christine222/TeamToast/ToastSchematic.brd

## EAGLE design ToastSchematic.brd (2017-12-01)

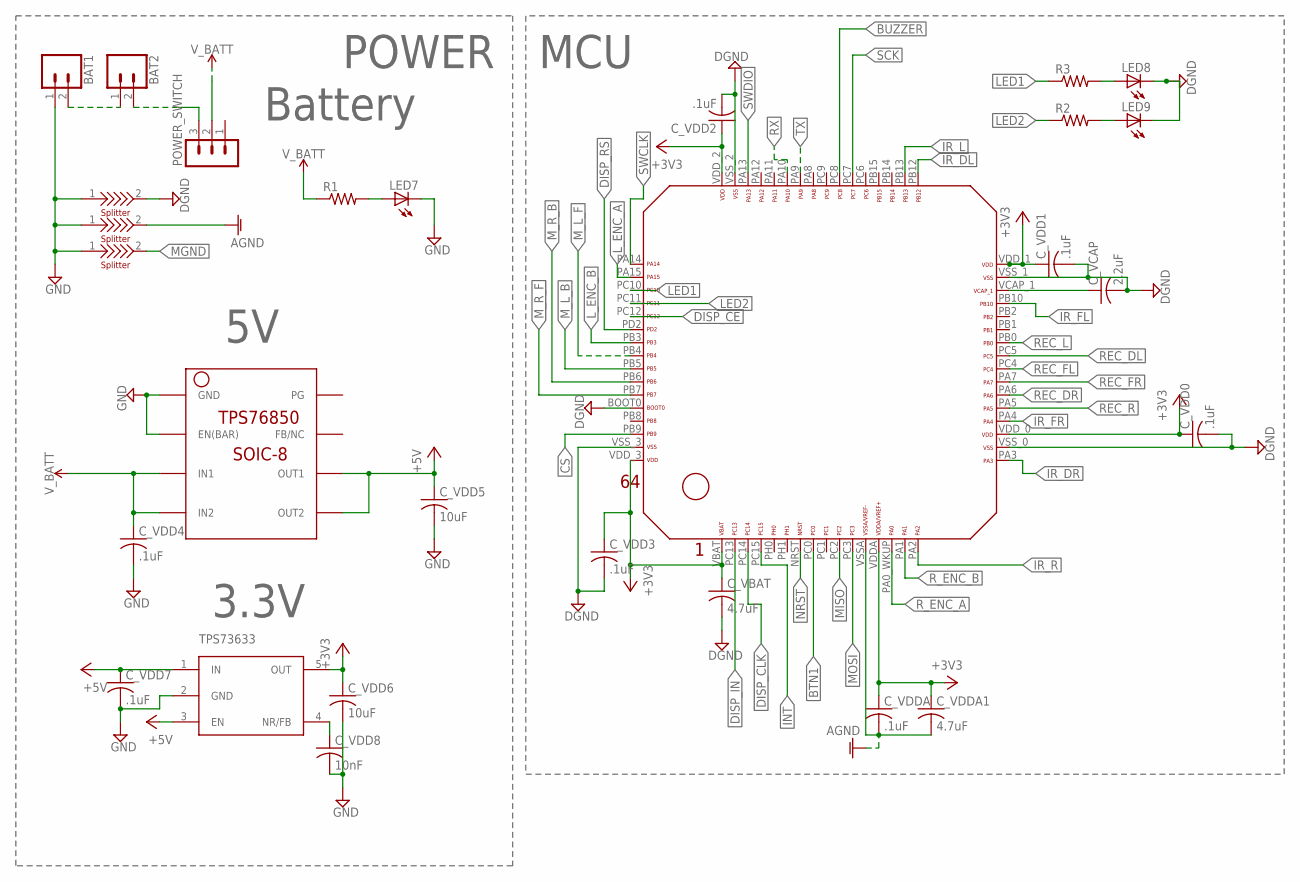
[picture p1: schematic ToastSchematic.sch, sheet 1]

Parts:
BAT1, BAT2: CONN_02JST-PTH-2; JST-2-PTH
C_VBAT: 4.7uF; C0603
C_VCAP: 2.2uF; C0603
C_VDD0, C_VDD1, C_VDD2, C_VDD3, C_VDD4, C_VDD7: .1uF; C0603
C_VDD5, C_VDD6: 10uF; C0603
C_VDD8: 10nF; C0603
C_VDDA: .1uF; C0603
C_VDDA1: 4.7uF; C0603
LED7: LED5MM
LED8, LED9: LEDCHIPLED_0603; CHIPLED_0603
POWER_SWITCH: MA03-1
R1, R2, R3: R-US_R0603; R0603
U$1: STM32F411/446_LQFP64
U$2: TPS73633; SOT23-5L
U$3: TPS76850(SOIC-8)
U$5, U$8, U$9: SPLITTER

Connections:
+3V3: C_VBAT.1, C_VDD0.1, C_VDD1.1, C_VDD2.1, C_VDD3.1, C_VDD6.1, C_VDDA.1, C_VDDA1.1, U$1.VBAT, U$1.VDDA, U$1.VDD_0, U$1.VDD_1, U$1.VDD_2, U$1.VDD_3, U$2.5 (OUT); also elsewhere on the board
+5V: C_VDD5.1, C_VDD7.1, U$2.1 (IN), U$2.3 (EN), U$3.OUT1, U$3.OUT2; also elsewhere on the board
AGND: C_VDDA.2, C_VDDA1.2, U$1.VSSA, U$8.2; also elsewhere on the board
BTN1: U$1.PC0; also elsewhere on the board
BUZZER: U$1.PC8; also elsewhere on the board
CS: U$1.PB9; also elsewhere on the board
DGND: C_VBAT.2, C_VCAP.2, C_VDD0.2, C_VDD1.2, C_VDD2.2, C_VDD3.2, LED8.C, LED9.C, U$1.BOOT0, U$1.VSS_0, U$1.VSS_1, U$1.VSS_2, U$1.VSS_3, U$5.2; also elsewhere on the board
DISP_CE: U$1.PC12; also elsewhere on the board
DISP_CLK: U$1.PC14; also elsewhere on the board
DISP_IN: U$1.PC13; also elsewhere on the board
DISP_RS: U$1.PD2; also elsewhere on the board
GND: BAT1.1, C_VDD4.2, C_VDD5.2, C_VDD6.2, C_VDD7.2, C_VDD8.2, LED7.K (C), U$2.2 (GND), U$3.EN(BAR), U$3.GND, U$5.1, U$8.1, U$9.1
INT: U$1.PC15; also elsewhere on the board
IR_DL: U$1.PB12; also elsewhere on the board
IR_DR: U$1.PA3; also elsewhere on the board
IR_FL: U$1.PB10; also elsewhere on the board
IR_FR: U$1.PA4; also elsewhere on the board
IR_L: U$1.PB13; also elsewhere on the board
IR_R: U$1.PA2; also elsewhere on the board
LED1: R3.1, U$1.PC10
LED2: R2.1, U$1.PC11
L_ENC_A: U$1.PA15; also elsewhere on the board
L_ENC_B: U$1.PB3; also elsewhere on the board
MGND: U$9.2; also elsewhere on the board
MISO: U$1.PC2; also elsewhere on the board
MOSI: U$1.PC3; also elsewhere on the board
M_L_B: U$1.PB5; also elsewhere on the board
M_L_F: U$1.PB4; also elsewhere on the board
M_R_B: U$1.PB6; also elsewhere on the board
M_R_F: U$1.PB7; also elsewhere on the board
unnamed: BAT1.2, BAT2.1
unnamed: BAT2.2, POWER_SWITCH.3
unnamed: C_VCAP.1, U$1.VCAP_1
unnamed: C_VDD8.1, U$2.4 (NR/FB)
unnamed: LED7.A, R1.2
unnamed: LED8.A, R3.2
unnamed: LED9.A, R2.2
NRST: U$1.NRST; also elsewhere on the board
REC_DL: U$1.PC5; also elsewhere on the board
REC_DR: U$1.PA6; also elsewhere on the board
REC_FL: U$1.PC4; also elsewhere on the board
REC_FR: U$1.PA7; also elsewhere on the board
REC_L: U$1.PB0; also elsewhere on the board
REC_R: U$1.PA5; also elsewhere on the board
RX: U$1.PA10; also elsewhere on the board
R_ENC_A: U$1.PA0_WKUP (PA0_AKUP); also elsewhere on the board
R_ENC_B: U$1.PA1; also elsewhere on the board
SCK: U$1.PC7; also elsewhere on the board
SWCLK: U$1.PA14; also elsewhere on the board
SWDIO: U$1.PA13; also elsewhere on the board
TX: U$1.PA9; also elsewhere on the board
V_BATT: C_VDD4.1, POWER_SWITCH.2, R1.1, U$3.IN1, U$3.IN2; also elsewhere on the board

Notes on the sheet:
MCU
POWER
3.3V
Battery

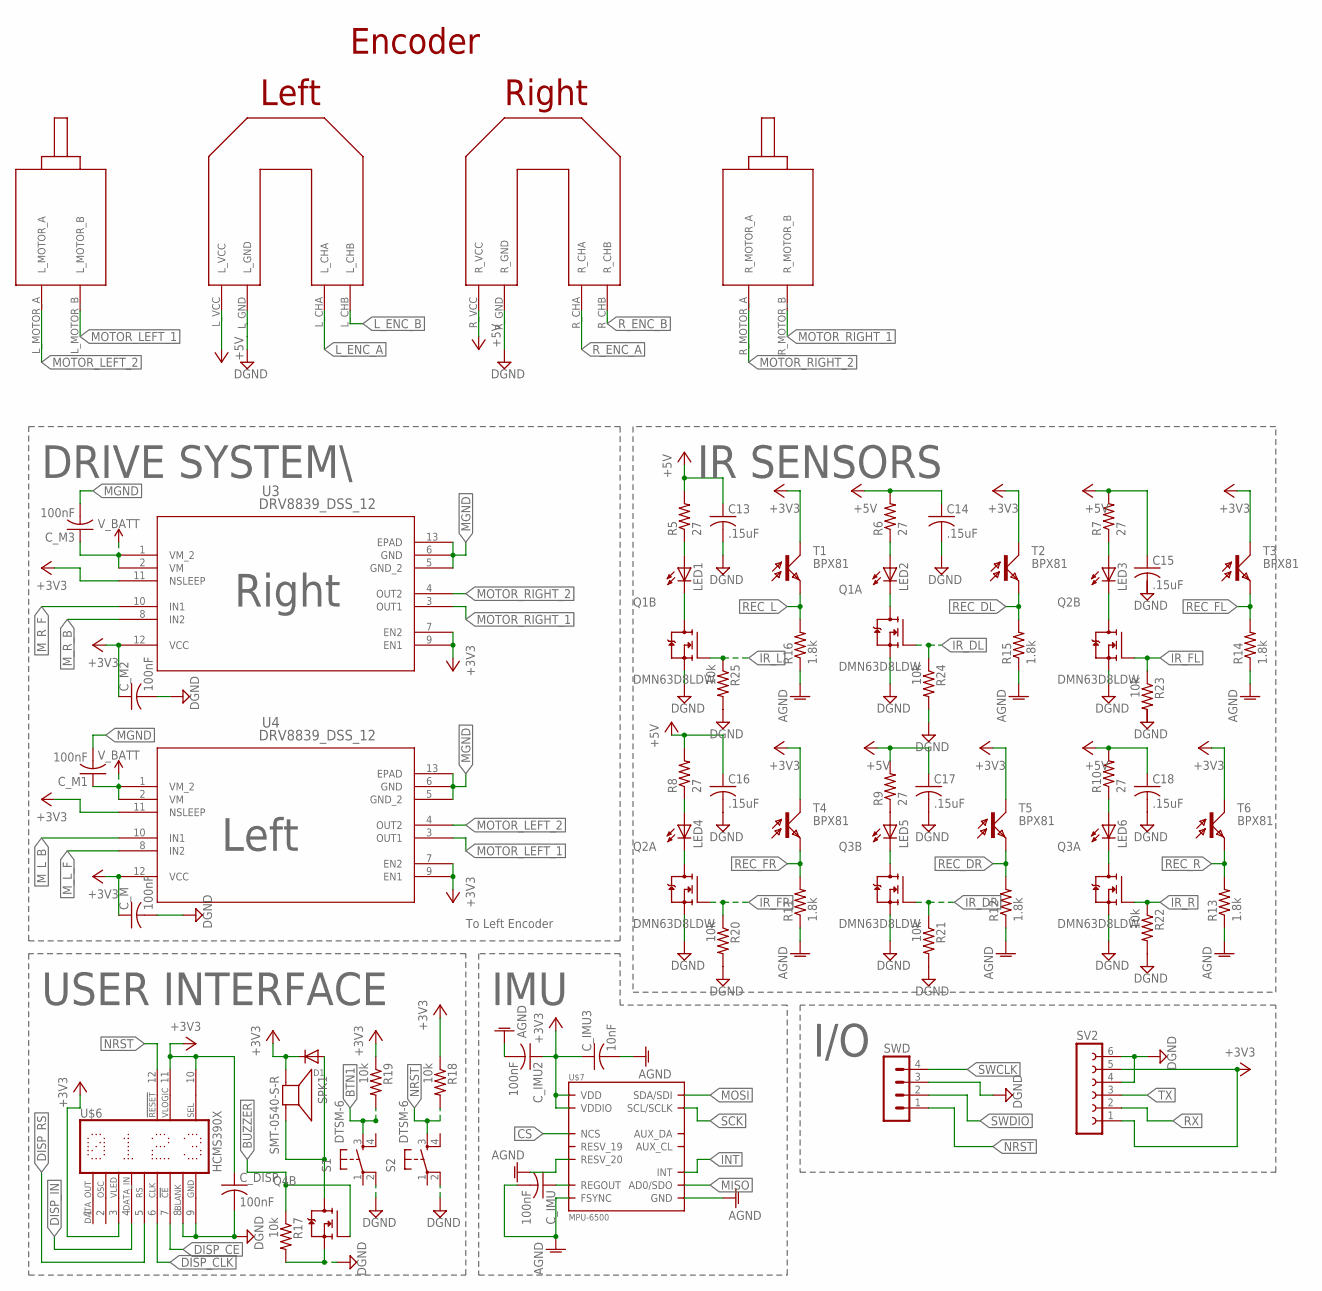
[picture p2: schematic ToastSchematic.sch, sheet 2]

Parts:
C13, C14, C15, C16, C17, C18: .15uF; C0603K
C_DISP: 100nF; C0603K
C_IMU, C_IMU2: 100nF; C0603K
C_IMU3: 10nF; C0603K
C_M, C_M1, C_M2, C_M3: 100nF; C0603K
D1: DIODESOD-323F; SOD-323F
LED1, LED2, LED3, LED4, LED5, LED6: LED5MM
Q1, Q2, Q3, Q4: DMN63D8LDW; SOT363
R5, R6, R7, R8, R9, R10: 27; R0603
R11, R12, R13, R14, R15, R16: 1.8k; R0603
R17, R18, R19, R20, R21, R22, R23, R24, R25: 10k; R0603
S1, S2: DTSM-6
SPK1: SMT-0540-S-R
SV2: FE06-1; FE06
SWD: MA04-1
T1, T2, T3, T4, T5, T6: BPX81
U3, U4: DRV8839_DSS_12; DSS12_P9X2
U$4: FUTURA_V1.0_MOTOR_MOUNT; FUTURA_V1.0_MOTOT_MOUNT
U$6: HCMS390X
U$7: MPU-6500; QFN.24.4X4

Connections:
+3V3: C_DISP.1, C_IMU2.1, C_IMU3.1, C_M.1, C_M2.1, D1.C, R18.1, R19.1, SPK1.- (+), SV2.1, SV2.5, T1.C, T2.C, T3.C, T4.C, T5.C, T6.C, U3.7 (EN2), U3.9 (EN1), U3.11 (NSLEEP), U3.12 (VCC), U4.7 (EN2), U4.9 (EN1), U4.11 (NSLEEP), U4.12 (VCC), U$6.3 (VLED), U$6.10 (SEL), U$6.11 (VLOGIC), U$7.8 (VDDIO), U$7.13 (VDD); also elsewhere on the board
+5V: C13.1, C14.1, C15.1, C16.1, C17.1, C18.1, R5.2, R6.2, R7.2, R8.2, R9.2, R10.2, U$4.L_VCC, U$4.R_VCC; also elsewhere on the board
AGND: C_IMU.2, C_IMU2.2, C_IMU3.2, R11.1, R12.1, R13.1, R14.1, R15.1, R16.1, U$7.11 (FSYNC), U$7.18 (GND), U$7.20 (RESV_20); also elsewhere on the board
BTN1: R19.2, S1.3; also elsewhere on the board
BUZZER: Q4.5 (G), R17.1; also elsewhere on the board
CS: U$7.22 (NCS); also elsewhere on the board
DGND: C13.2, C14.2, C16.2, C17.2, C18.2, C_DISP.2, C_M.2, C_M2.2, Q1.1 (S), Q1.4 (S), Q2.1 (S), Q2.4 (S), Q3.1 (S), Q3.4 (S), Q4.4 (S), R17.2, R20.2, R21.2, R22.2, R24.2, R25.2, S1.2, S2.2, SV2.4, SV2.6, SWD.3, U$4.L_GND, U$4.R_GND, U$6.8 (BLANK), U$6.9 (GND); also elsewhere on the board
DISP_CE: U$6.7 (!CE); also elsewhere on the board
DISP_CLK: U$6.6 (CLK); also elsewhere on the board
DISP_IN: U$6.4 (IN); also elsewhere on the board
DISP_RS: U$6.5 (RS); also elsewhere on the board
INT: U$7.12 (INT); also elsewhere on the board
IR_DL: Q1.2 (G), R24.1; also elsewhere on the board
IR_DR: Q3.5 (G), R21.1; also elsewhere on the board
IR_FL: Q2.5 (G), R23.1; also elsewhere on the board
IR_FR: Q2.2 (G), R20.1; also elsewhere on the board
IR_L: Q1.5 (G), R25.1; also elsewhere on the board
IR_R: Q3.2 (G), R22.1; also elsewhere on the board
L_ENC_A: U$4.L_CHA; also elsewhere on the board
L_ENC_B: U$4.L_CHB; also elsewhere on the board
MGND: C_M1.2, C_M3.2, U3.5 (GND_2), U3.6 (GND), U3.13 (EPAD), U4.5 (GND_2), U4.6 (GND), U4.13 (EPAD); also elsewhere on the board
MISO: U$7.9 (AD0/SDO); also elsewhere on the board
MOSI: U$7.24 (SDA/SDI); also elsewhere on the board
MOTOR_LEFT_1: U4.3 (OUT1), U$4.L_MOTOR_B
MOTOR_LEFT_2: U4.4 (OUT2), U$4.L_MOTOR_A
MOTOR_RIGHT_1: U3.3 (OUT1), U$4.R_MOTOR_B
MOTOR_RIGHT_2: U3.4 (OUT2), U$4.R_MOTOR_A
M_L_B: U4.10 (IN1); also elsewhere on the board
M_L_F: U4.8 (IN2); also elsewhere on the board
M_R_B: U3.8 (IN2); also elsewhere on the board
M_R_F: U3.10 (IN1); also elsewhere on the board
unnamed: LED1.A, R5.1
unnamed: LED1.K (C), Q1.3 (D)
unnamed: LED2.A, R6.1
unnamed: LED2.K (C), Q1.6 (D)
unnamed: LED3.K (C), Q2.3 (D)
unnamed: LED3.A, R7.1
unnamed: LED6.A, R10.1
unnamed: LED6.K (C), Q3.6 (D)
unnamed: LED4.A, R8.1
unnamed: C_IMU.1, U$7.10 (REGOUT)
unnamed: LED4.K (C), Q2.6 (D)
unnamed: LED5.A, R9.1
unnamed: LED5.K (C), Q3.3 (D)
unnamed: D1.A, Q4.3 (D), SPK1.+ (-)
NRST: R18.2, S2.3, SWD.1, U$6.12 (NOT_RESET); also elsewhere on the board
REC_DL: R15.2, T2.E; also elsewhere on the board
REC_DR: R12.2, T5.E; also elsewhere on the board
REC_FL: R14.2, T3.E; also elsewhere on the board
REC_FR: R11.2, T4.E; also elsewhere on the board
REC_L: R16.2, T1.E; also elsewhere on the board
REC_R: R13.2, T6.E; also elsewhere on the board
RX: SV2.2; also elsewhere on the board
R_ENC_A: U$4.R_CHA; also elsewhere on the board
R_ENC_B: U$4.R_CHB; also elsewhere on the board
SCK: U$7.23 (SCL/SCLK); also elsewhere on the board
SWCLK: SWD.4; also elsewhere on the board
SWDIO: SWD.2; also elsewhere on the board
TX: SV2.3; also elsewhere on the board
V_BATT: C_M1.1, C_M3.1, U3.1 (VM_2), U3.2 (VM), U4.1 (VM_2), U4.2 (VM); also elsewhere on the board

Notes on the sheet:
DRIVE SYSTEM\
Right
Left
USER INTERFACE
IR SENSORS
IMU
I/O
To Left Encoder

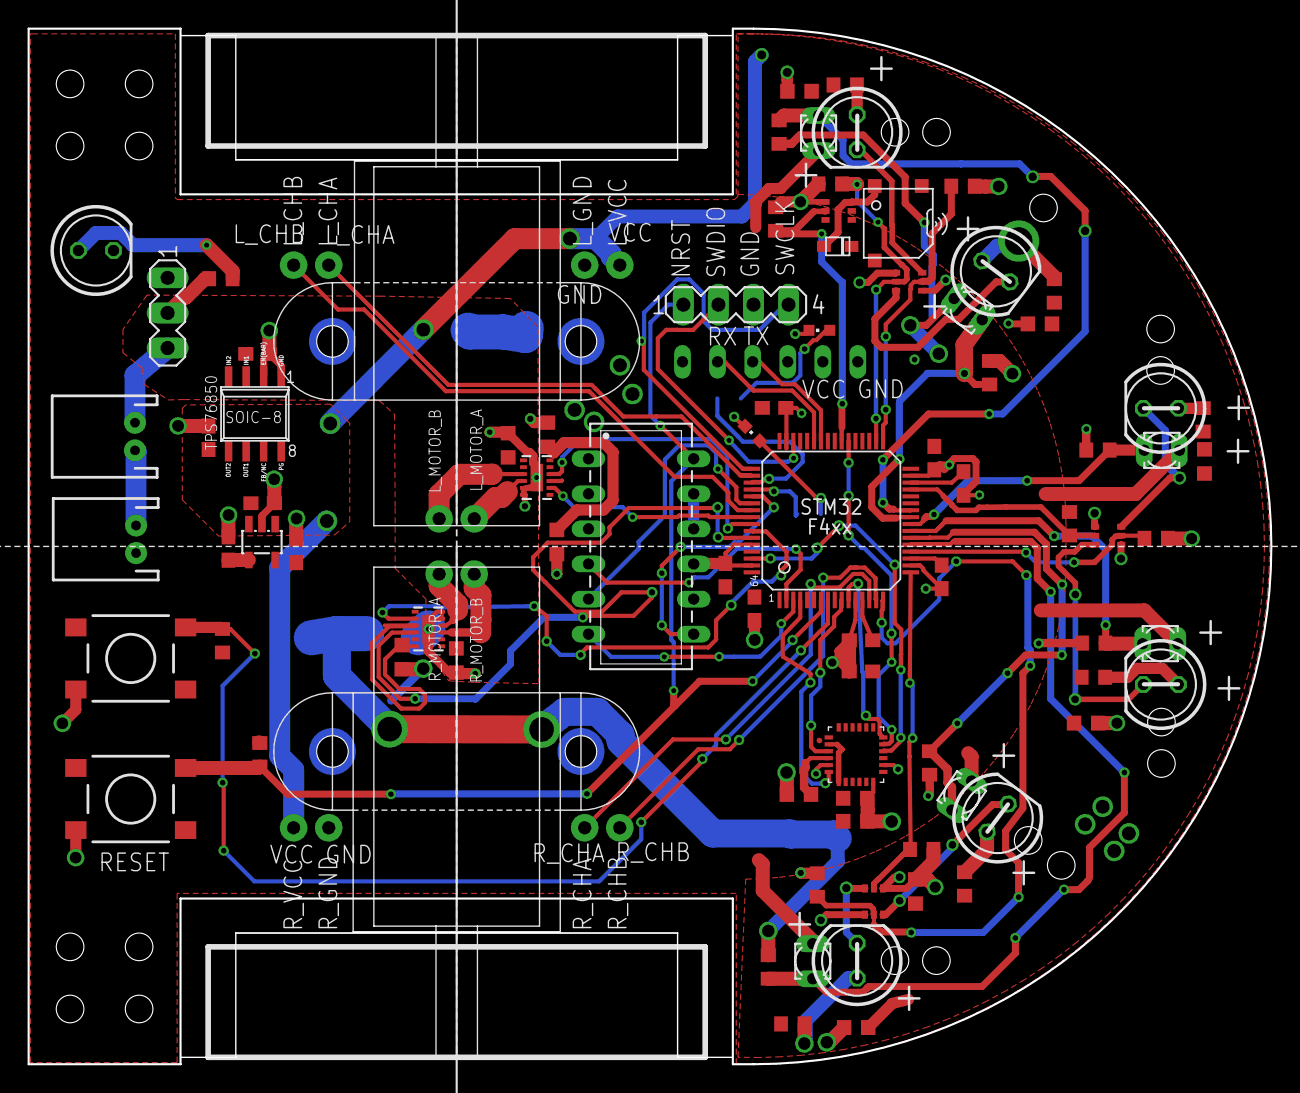
[picture p3: board ToastSchematic.brd from above]

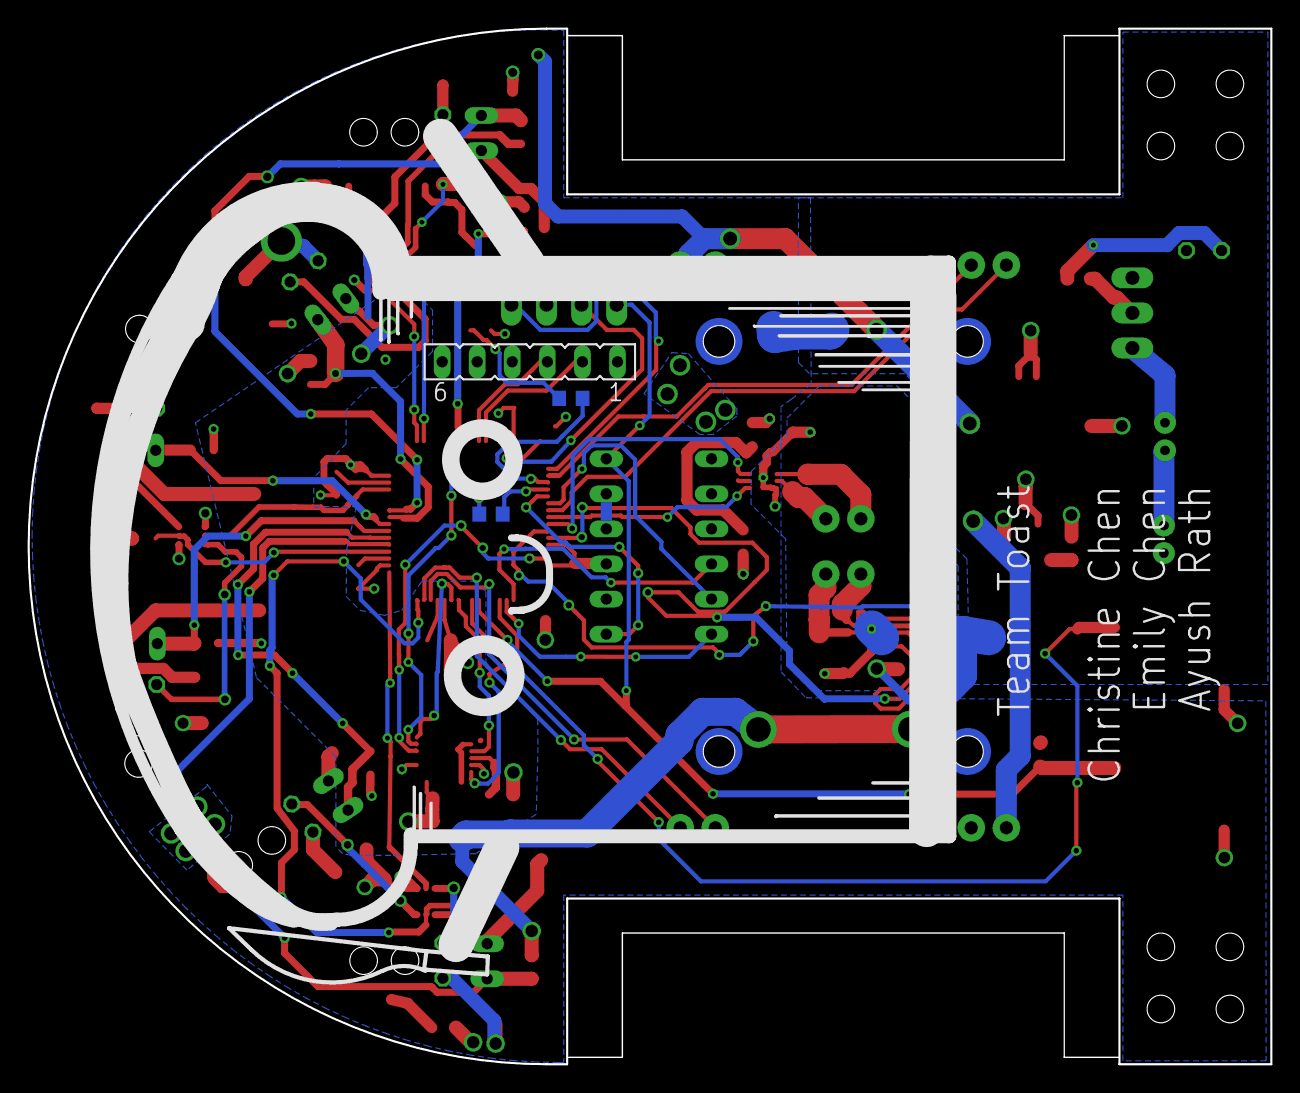
[picture p4: board ToastSchematic.brd from below]

Board: 2 copper layers, 90.0 x 75.0 mm, 90 parts (6 on the bottom side), 70 nets.
