christine222/TeamToast/encoder.brd

## EAGLE design encoder.brd (2017-11-08)

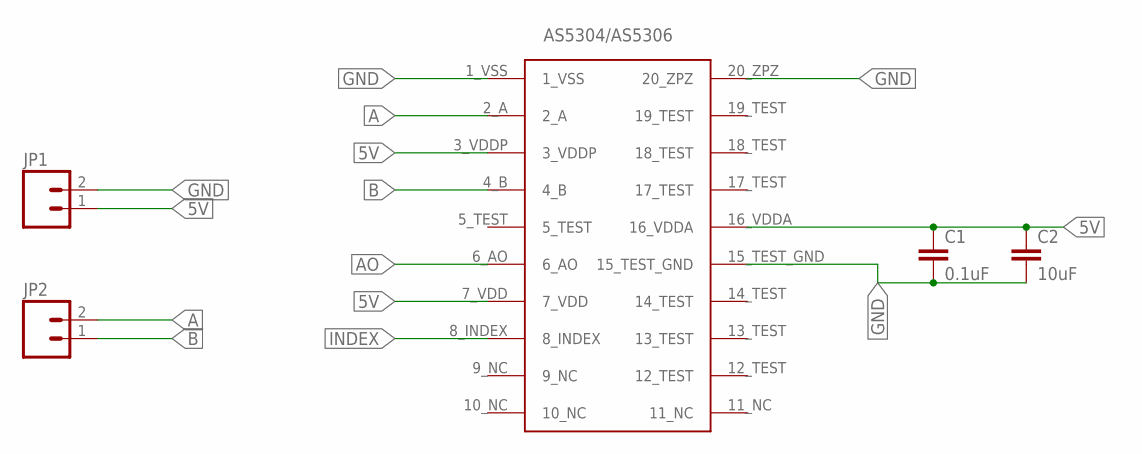
[picture p5: schematic encoder.sch]

Parts:
C1: 0.1uF; C0603
C2: 10uF; C0603
JP1, JP2: M02LOCK; 1X02_LOCK
U$1: AS5304/AS5306-ENCODER

Connections:
5V: C1.1, C2.1, JP1.1, U$1.3_VDDP, U$1.7_VDD, U$1.16_VDDA
A: JP2.2, U$1.2_A
AO: U$1.6_AO
B: JP2.1, U$1.4_B
GND: C1.2, C2.2, JP1.2, U$1.1_VSS, U$1.15_TEST_GND, U$1.20_ZPZ
INDEX: U$1.8_INDEX

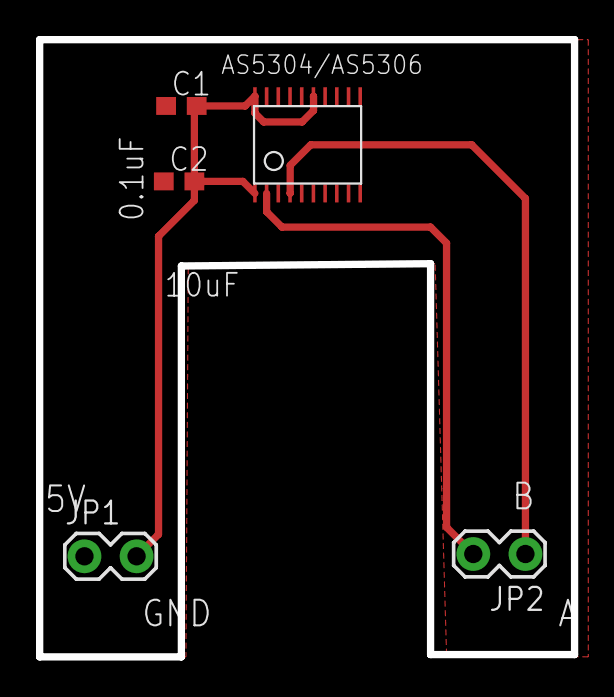
[picture p6: board encoder.brd from above]

Board: 2 copper layers, 29.7 x 34.3 mm, 5 parts (0 on the bottom side), 4 nets.
