christine222/TeamToast/(commit log)

2017-11-08 Added schematic to repo
    [ToastSchematic.sch]
2017-11-08 Adding Futura Encoders
    encoder brd and sch
    [encoder.brd, encoder.sch]
2017-11-09 started pcb board layout
    put parts where they should be
    [ToastSchematic.brd, ToastSchematic.sch]
2017-11-09 added gnd plane
    added gnd plane
    [ToastSchematic.brd, ToastSchematic.sch]
2017-11-09 did dgnd, agnd, and gnd planes
    added some traces, still need to add all the power planes
    [ToastSchematic.brd]
2017-11-09 added 5V plane
    [ToastSchematic.brd]
2017-11-10 some routing
    Partially routed IRs and other stuff
    [ToastSchematic.brd]
2017-11-10 Restarted routing
    [ToastSchematic.brd]
2017-11-10 Added Ground Splitter
    [ToastSchematic.brd, ToastSchematic.sch]
2017-11-10 Get everything on cheap week
    [ToastSchematic.brd]
2017-11-11 Did more routing
    [ToastSchematic.brd, ToastSchematic.sch]
2017-11-25 Finished Routing Board
    [ToastSchematic.brd]
2017-11-27 Added text to bottom of board
    [ToastSchematic.brd]
2017-11-30 Minor Fixes
    [ToastSchematic.brd, ToastSchematic.sch]
2017-11-30 added routing and some mounting holes
    [ToastSchematic.brd]
2017-12-01 fixed bottleneck and minor issues
    [ToastSchematic.brd]
2017-12-01 Added mounting holes for IR
    [ToastSchematic.brd]
2017-12-01 finished wiring everything
    still need to add toast and butter pics on the back and smash and label
    stuff
    [ToastSchematic.brd, ToastSchematic.sch]
2017-12-01 Added art to board
    [ToastSchematic.brd, ToastSchematic.sch]
